Hackin7/maibadge/README.md

# maibadge
maimai badge project. PCB badges with maimai themes
