Hackin7/maibadge/code/maifaces/clown.jpg

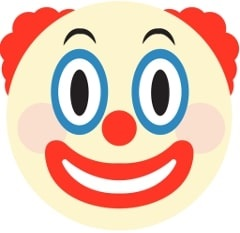
code/maifaces/clown.jpg
