Hackin7/maibadge/code/maifaces/maibear1.jpg

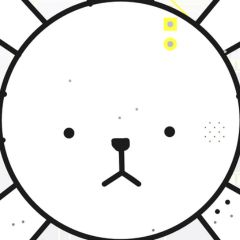
code/maifaces/maibear1.jpg
