Hackin7/maibadge/code/maifaces/study harder/maibear_study_water_thing.jpg

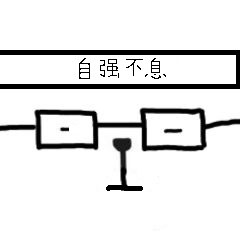
code/maifaces/study harder/maibear_study_water_thing.jpg
