Hackin7/maibadge/pcbs/Justin/flashlight_esm_cat/flashlight2.kicad_pcb

## KiCad design pcbs/Justin/flashlight_esm_cat/flashlight2.kicad_pcb (2025-01-23)

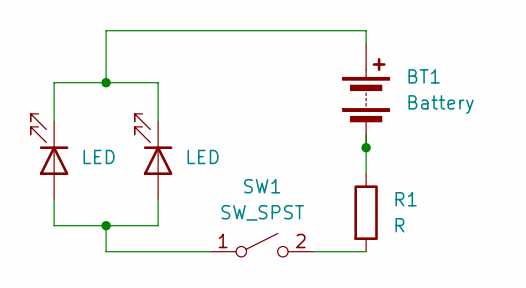
[picture p12: schematic flashlight2.kicad_sch]

Parts:
BT1: Battery; BatteryHolder_Keystone_106_1x20mm
D1, D2: LED; LED_D3.0mm
R1: R; R_0805_2012Metric_Pad1.20x1.40mm_HandSolder
SW1: SW_SPST; SS12D00

Connections:
unnamed: BT1.1 (+), D1.1 (K), D2.1 (K)
unnamed: BT1.2 (-), R1.1
unnamed: D1.2 (A), D2.2 (A), SW1.1 (A)
unnamed: R1.2, SW1.2 (B)

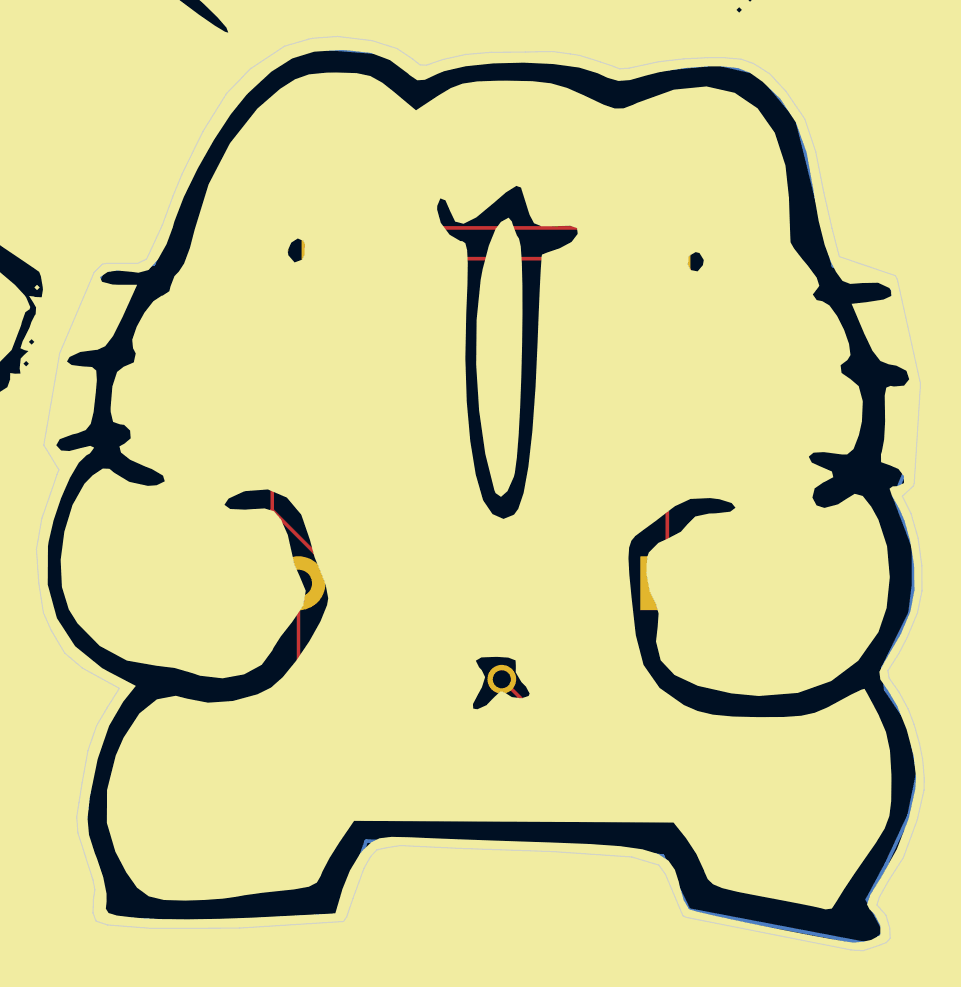
[picture p13: board flashlight2.kicad_pcb from above]

Board: 2 copper layers, 49.3 x 50.8 mm, 5 parts (1 on the bottom side), 4 nets.
