Hackin7/maibadge/pcbs/Justin/maibadge/maibadge_ver2.kicad_pcb

## KiCad design pcbs/Justin/maibadge/maibadge_ver2.kicad_pcb (2025-01-23)

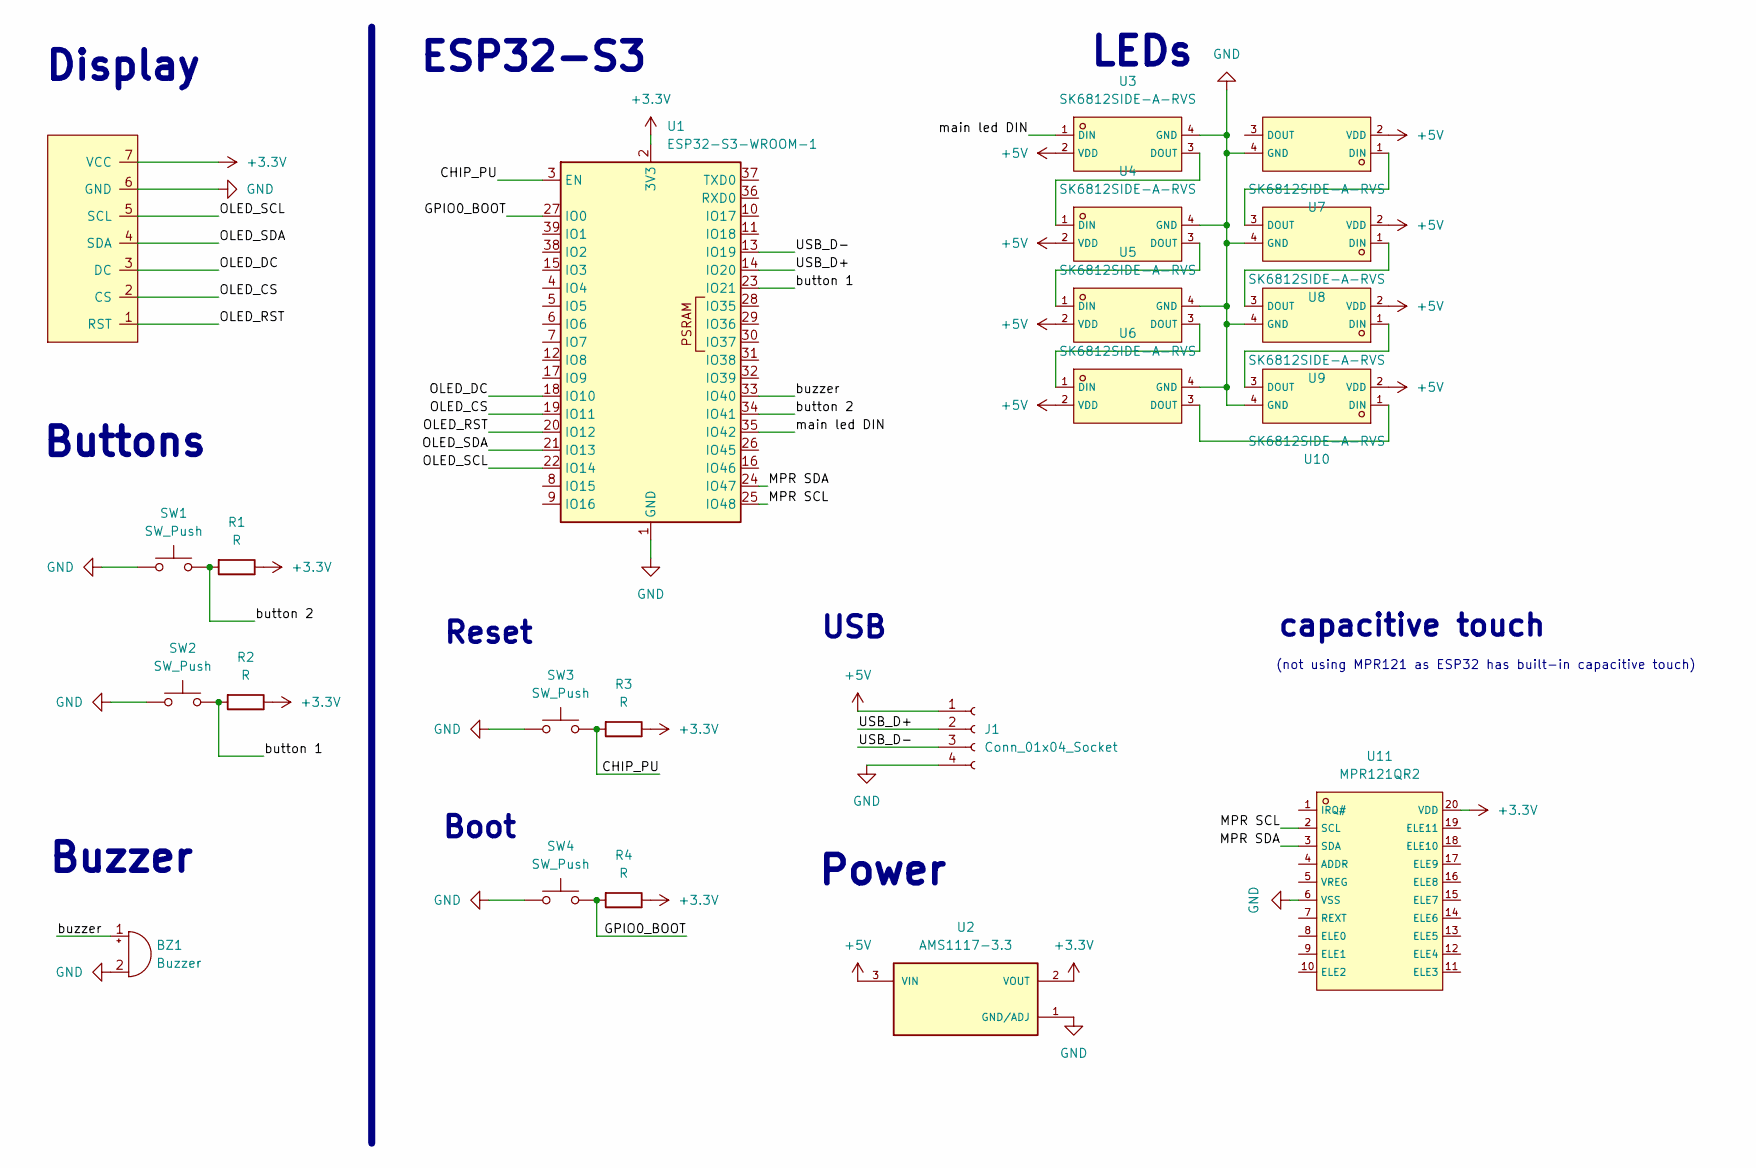
[picture p14: schematic maibadge_ver2.kicad_sch]

Parts:
BZ1: Buzzer; BUZ-SMD_4P-L7.5-W7.5-BR
GC9A1: CG9A01; GC9A01
J1: Conn_01x04_Socket; PinHeader_1x04_P2.54mm_Vertical
R1, R2, R3, R4: R; R_0805_2012Metric_Pad1.20x1.40mm_HandSolder
SW1, SW2, SW3, SW4: SW_Push; SW_Push_1P1T_XKB_TS-1187A
U1: ESP32-S3-WROOM-1
U2: AMS1117-3.3; SOT-89-3_L4.5-W2.5-P1.50-LS4.2-BR; PARTREV N/A
U3, U4, U5, U6, U7, U8, U9, U10: SK6812SIDE-A-RVS; LED-SMD_4P-L4.0-W1.6-L; LCSC C2890037
U11: MPR121QR2; QFN-20_L3.0-W3.0-P0.40-BL; LCSC C91322

Connections:
+3.3V: GC9A1.7 (VCC), R1.1, R2.1, R3.1, R4.1, U1.2 (3V3), U2.2 (VOUT), U11.20 (VDD)
+5V: J1.1, U2.3 (VIN), U3.2 (VDD), U4.2 (VDD), U5.2 (VDD), U6.2 (VDD), U7.2 (VDD), U8.2 (VDD), U9.2 (VDD), U10.2 (VDD)
/CHIP_PU: R3.2, SW3.2, U1.3 (EN)
/GPIO0_BOOT: R4.2, SW4.2, U1.27 (IO0)
/MPR SCL: U1.25 (IO48), U11.2 (SCL)
/MPR SDA: U1.24 (IO47), U11.3 (SDA)
/OLED_CS: GC9A1.2 (CS), U1.19 (IO11)
/OLED_DC: GC9A1.3 (DC), U1.18 (IO10)
/OLED_RST: GC9A1.1 (RST), U1.20 (IO12)
/OLED_SCL: GC9A1.5 (SCL), U1.22 (IO14)
/OLED_SDA: GC9A1.4 (SDA), U1.21 (IO13)
/USB_D+: J1.2, U1.14 (IO20)
/USB_D-: J1.3, U1.13 (IO19)
/button 1: R2.2, SW2.2, U1.23 (IO21)
/button 2: R1.2, SW1.2, U1.34 (IO41)
/buzzer: BZ1.1 (+), U1.33 (IO40)
/main led DIN: U1.35 (IO42), U3.1 (DIN)
GND: BZ1.2 (-), GC9A1.6 (GND), J1.4, SW1.1, SW2.1, SW3.1, SW4.1, U1.1 (GND), U1.40 (GND), U1.41 (GND), U2.1 (GND/ADJ), U3.4 (GND), U4.4 (GND), U5.4 (GND), U6.4 (GND), U7.4 (GND), U8.4 (GND), U9.4 (GND), U10.4 (GND), U11.6 (VSS)
unnamed: U3.3 (DOUT), U4.1 (DIN)
unnamed: U4.3 (DOUT), U5.1 (DIN)
unnamed: U5.3 (DOUT), U6.1 (DIN)
unnamed: U7.1 (DIN), U8.3 (DOUT)
unnamed: U8.1 (DIN), U9.3 (DOUT)
unnamed: U6.3 (DOUT), U10.1 (DIN)
unnamed: U9.1 (DIN), U10.3 (DOUT)

Notes on the sheet:
Buzzer
capacitive touch
Buttons
USB
ESP32-S3
LEDs
Boot
Reset
Power
(not using MPR121 as ESP32 has built-in capacitive touch)
Display

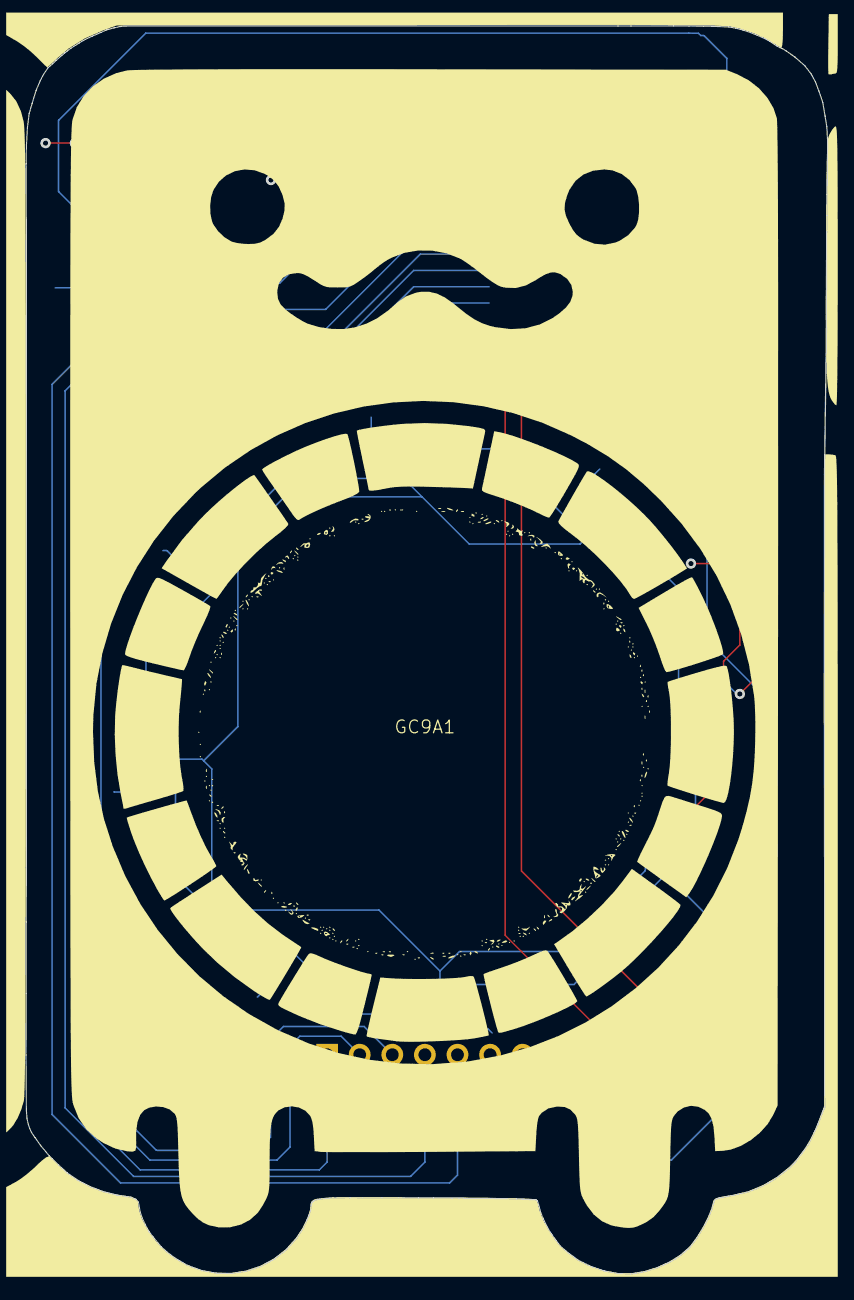
[picture p15: board maibadge_ver2.kicad_pcb from above]

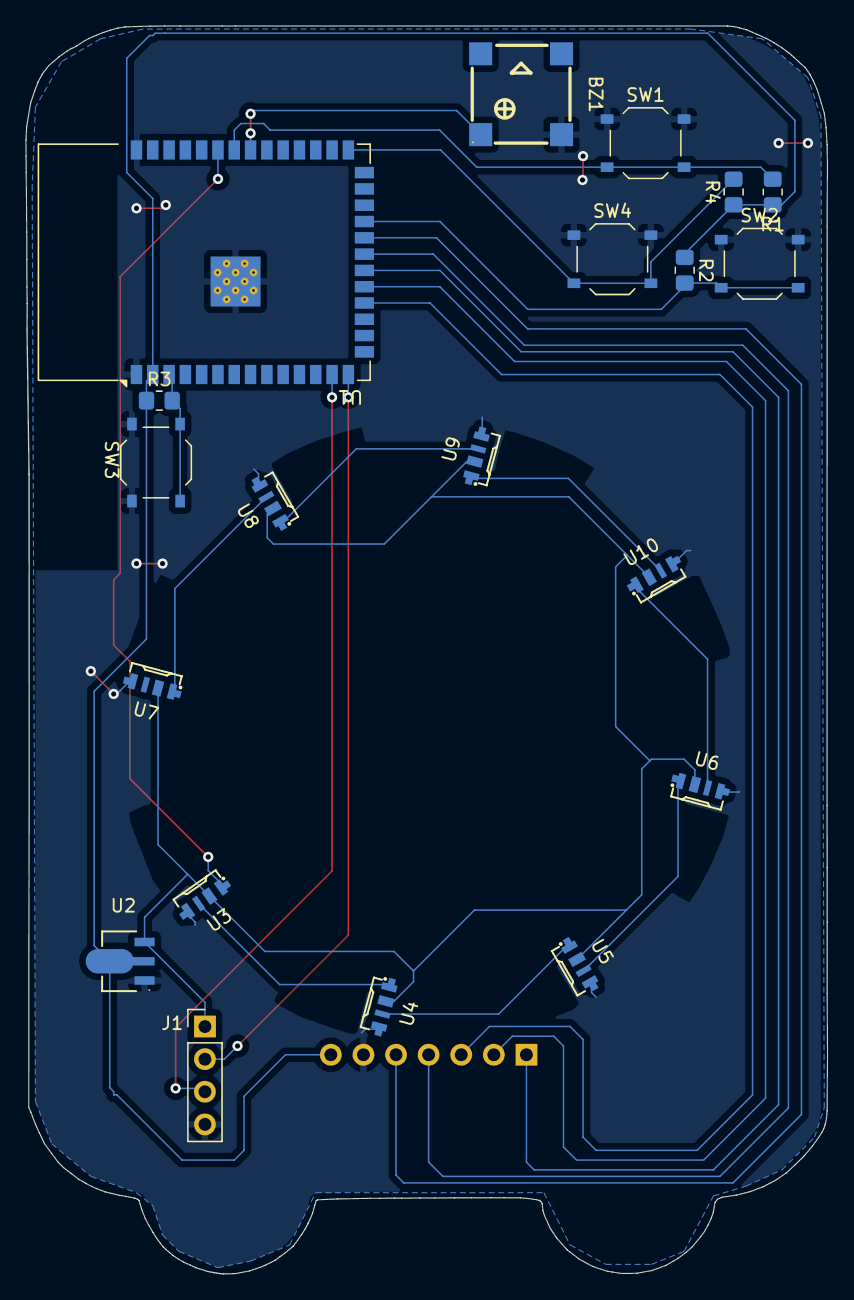
[picture p16: board maibadge_ver2.kicad_pcb from below]

Board: 2 copper layers, 62.5 x 97.2 mm, 21 parts (20 on the bottom side), 23 nets.
