Hackin7/maibadge/howard_flashlight schematic/flashlight schematic.kicad_pcb

## KiCad design howard_flashlight schematic/flashlight schematic.kicad_pcb (2024-11-18)

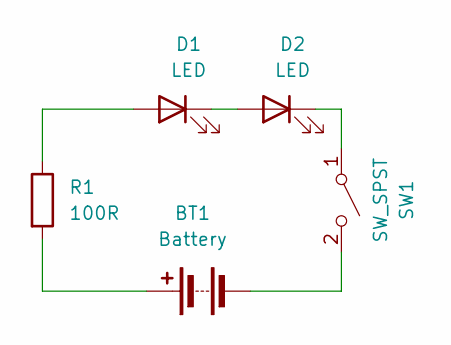
[picture p19: schematic flashlight schematic.kicad_sch]

Parts:
BT1: Battery; BatteryHolder_Keystone_106_1x20mm
D1, D2: LED; LED_D1.8mm_W1.8mm_H2.4mm_Horizontal_O1.27mm_Z1.6mm
R1: 100R; R_0201_0603Metric
SW1: SW_SPST; SW_DIP_SPSTx01_Slide_6.7x4.1mm_W6.73mm_P2.54mm_LowProfile_J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

Connections:
unnamed: BT1.1 (+), R1.2
unnamed: BT1.2 (-), SW1.2 (B)
unnamed: D1.2 (A), R1.1
unnamed: D1.1 (K), D2.2 (A)
unnamed: D2.1 (K), SW1.1 (A)

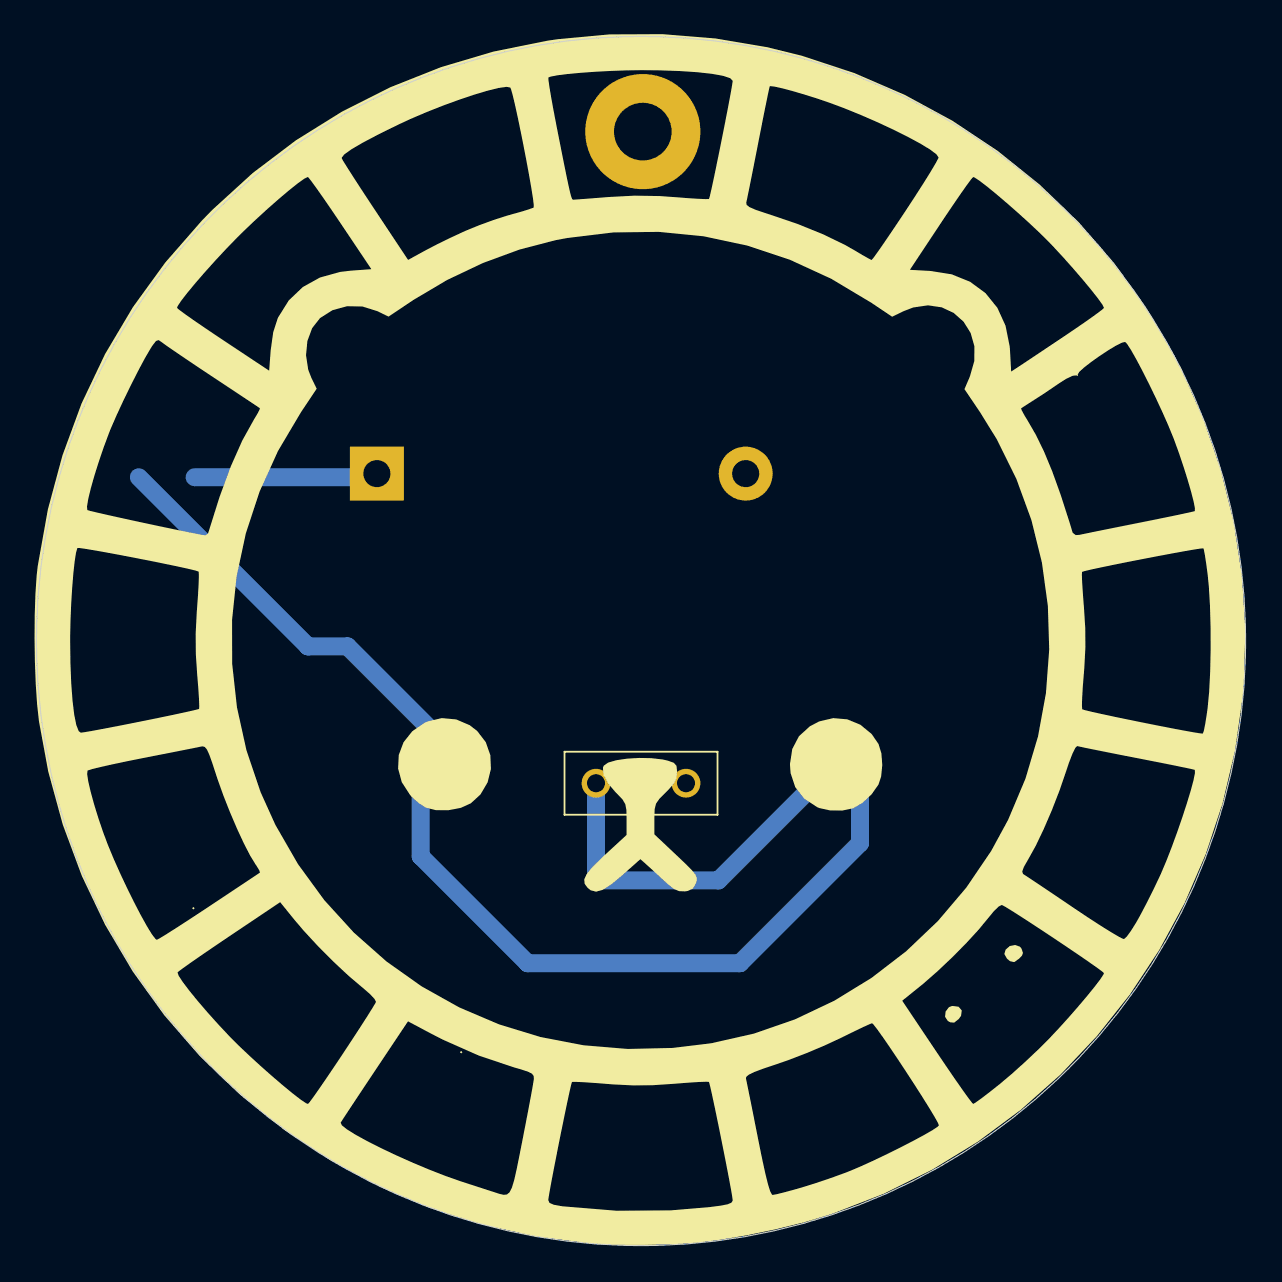
[picture p20: board flashlight schematic.kicad_pcb from above]

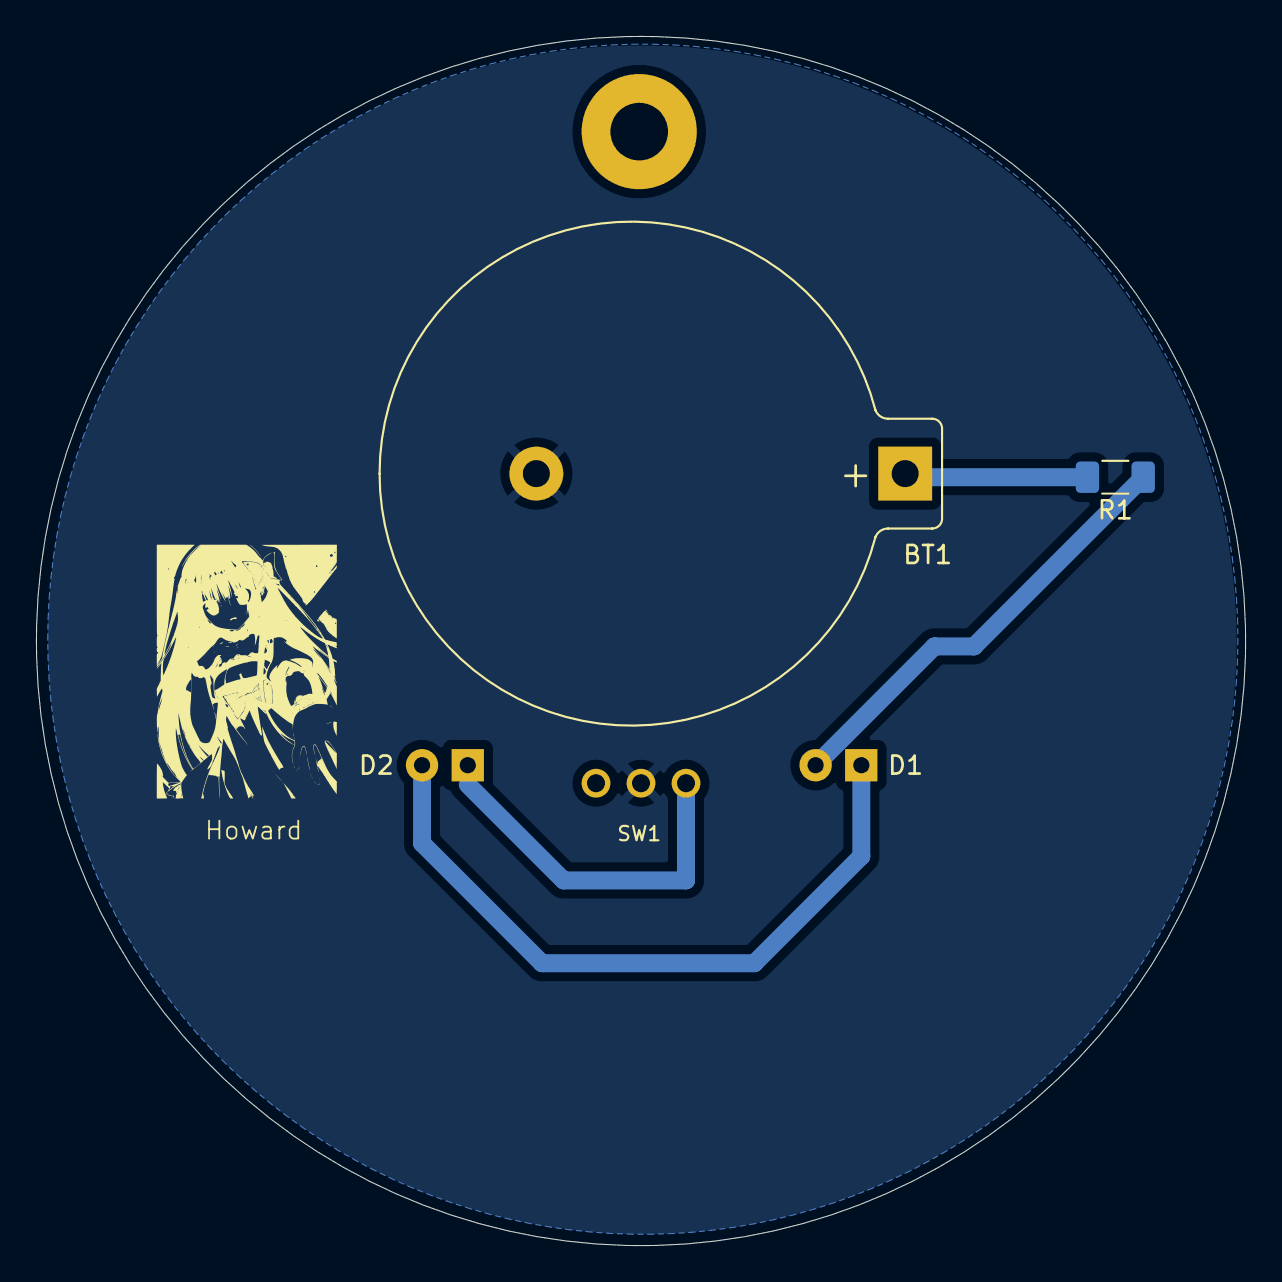
[picture p21: board flashlight schematic.kicad_pcb from below]

Board: 2 copper layers, 67.2 x 67.2 mm, 5 parts (2 on the bottom side), 5 nets.
