Hackin7/maibadge/code/main/apps/template.py

class AppTemplate:
    def __init__(self, hardware):
        self.hardware = hardware
        
    def load(self):
        print("Not Implemented!")
    
    def unload(self):
        print("Not Implemented!")
