Hackin7/maibadge/code/main/boot.py

# This file is executed on every boot (including wake-boot from deepsleep)
#import esp
#esp.osdebug(None)
#import webrepl
#webrepl.start()
from hardware import ref
import hardware.vga1_8x16 as smallfont
import hardware.vga1_bold_16x32 as bigfont

from machine import Timer
import time
import gc
from machine import Pin, I2C, PWM, SPI, freq, SoftSPI
import gc9a01

gc.enable()
gc.collect()
# Handle button events with display
#def my_button_handler(pin):
#   display_update(pin)

from apps.maiface import MaiFace
from apps.maimenu import MaiMenu    
## Button handler
previous_button_press = 0 #to track time


#move_to_menu()


mm = MaiMenu(ref)
def move_to_menu():
    global mm
    mm.load(display=False)
mf = MaiFace(ref)
mf.load(exit_callback=mm.load)
# Periodically update display
#tim = Timer(0) #timer id 0
#tim.init(period=10000, mode=Timer.PERIODIC, callback=lambda t: display_update()) #self refreshes every 10s

        
#from app import maigame

#tft.fill(gc9a01.BLACK)
#maigame.playfield(tft)
#maigame.animation(tft, buttons)
