Hackin7/maibadge/(commit log)

2024-08-18 feat: initial bear pcb
    [maibadge_bear_v1.kicad_pcb, maibadge_bear_v1.kicad_sch]
2024-08-18 feat: component placement adjustments
    [maibadge_bear_v1.kicad_pcb, maibadge_bear_v1.kicad_sch]
2024-08-19 changed OLED routing to HSPI, changed footprint for buttons and resistors, finished routing, ensured no components behind the 8 buttons
    [maibadge_bear_v1.kicad_pcb, maibadge_bear_v1.kicad_sch]
2024-08-23 files for hardware
    [maibadge_bear_v1.kicad_sch]
2024-08-26 pcb routing fixed
    [maibadge_bear_v1.kicad_pcb, maibadge_bear_v1.kicad_sch]
2024-09-04 order 1
    [maibadge_bear_v1.kicad_pcb]
2024-09-18 added leds and mpr121 for pcb
    [maibadge_bear_v1.kicad_pcb, maibadge_bear_v1.kicad_sch]
2024-09-26 prototype 2 done
    [maibadge_bear_v1.kicad_pcb, maibadge_bear_v1.kicad_sch]
2024-10-28 prototype 2 rehaul finished
    [maibadge_bear_v1.kicad_pcb, maibadge_bear_v1.kicad_sch]
2024-11-17 feat: buzz + animate
    [buzzer.py, maiface.py, maigame.py, maimenu.py, template.py]
2024-11-18 final changes
    [maibadge_bear_v1.kicad_pcb]
2024-11-25 button memory but failed maigame_2
    [boot.py, maigame.py, maigame_2.py, maimenu.py, touchpads.py]
2025-03-01 Added website files to pcbs/Justin/website
